Nikolas-05/Magic-Wand/Sketches/01_side_and_top.png

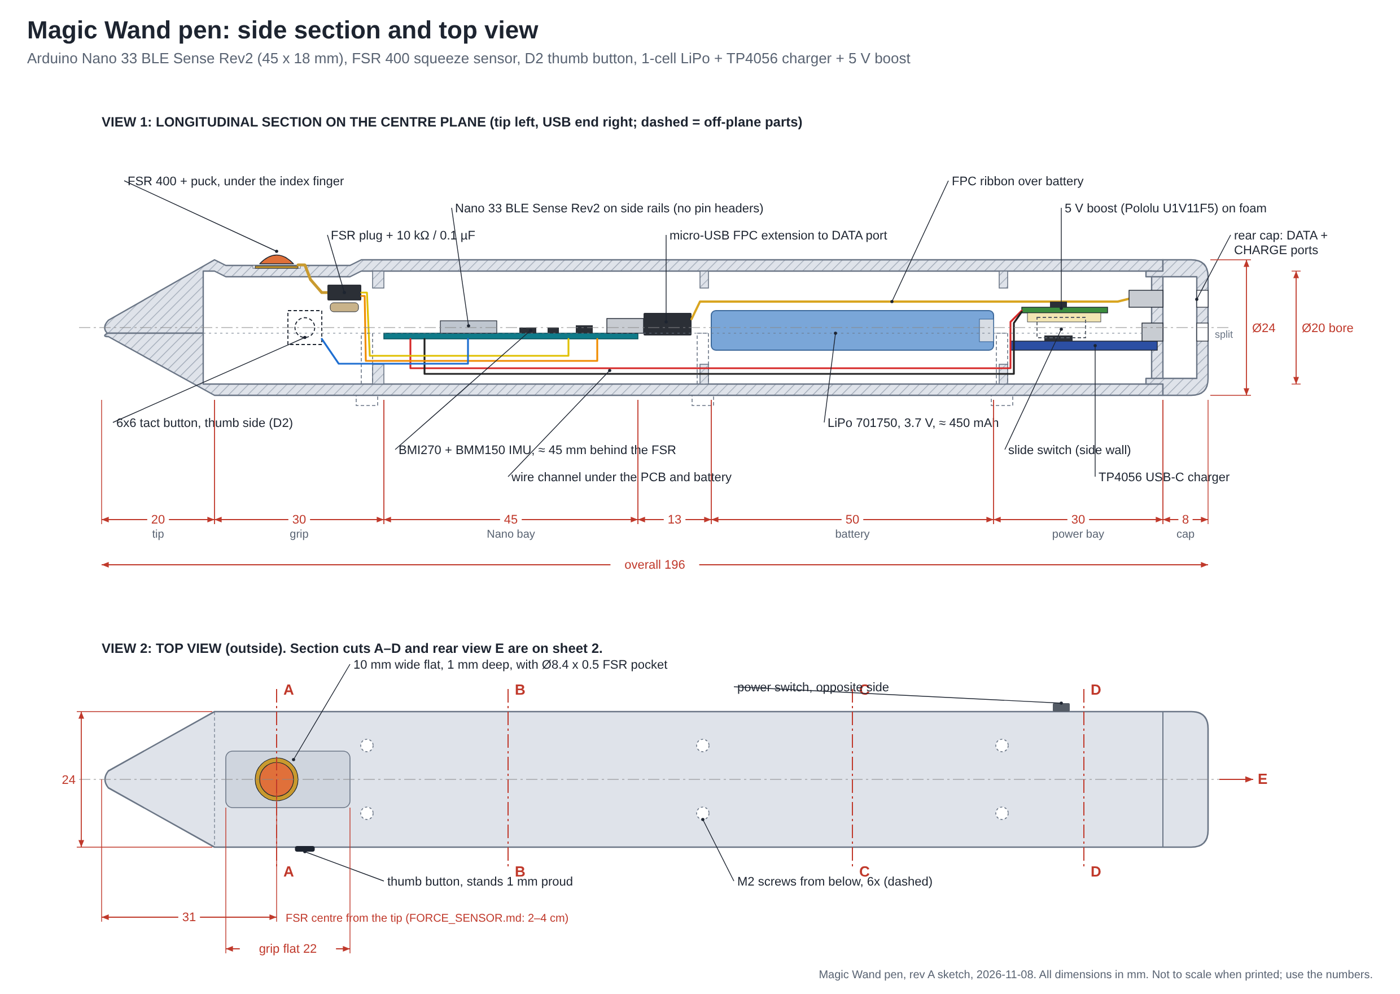
Sketches/01_side_and_top.png
