Nikolas-05/Magic-Wand/Sketches/02_cross_sections.png

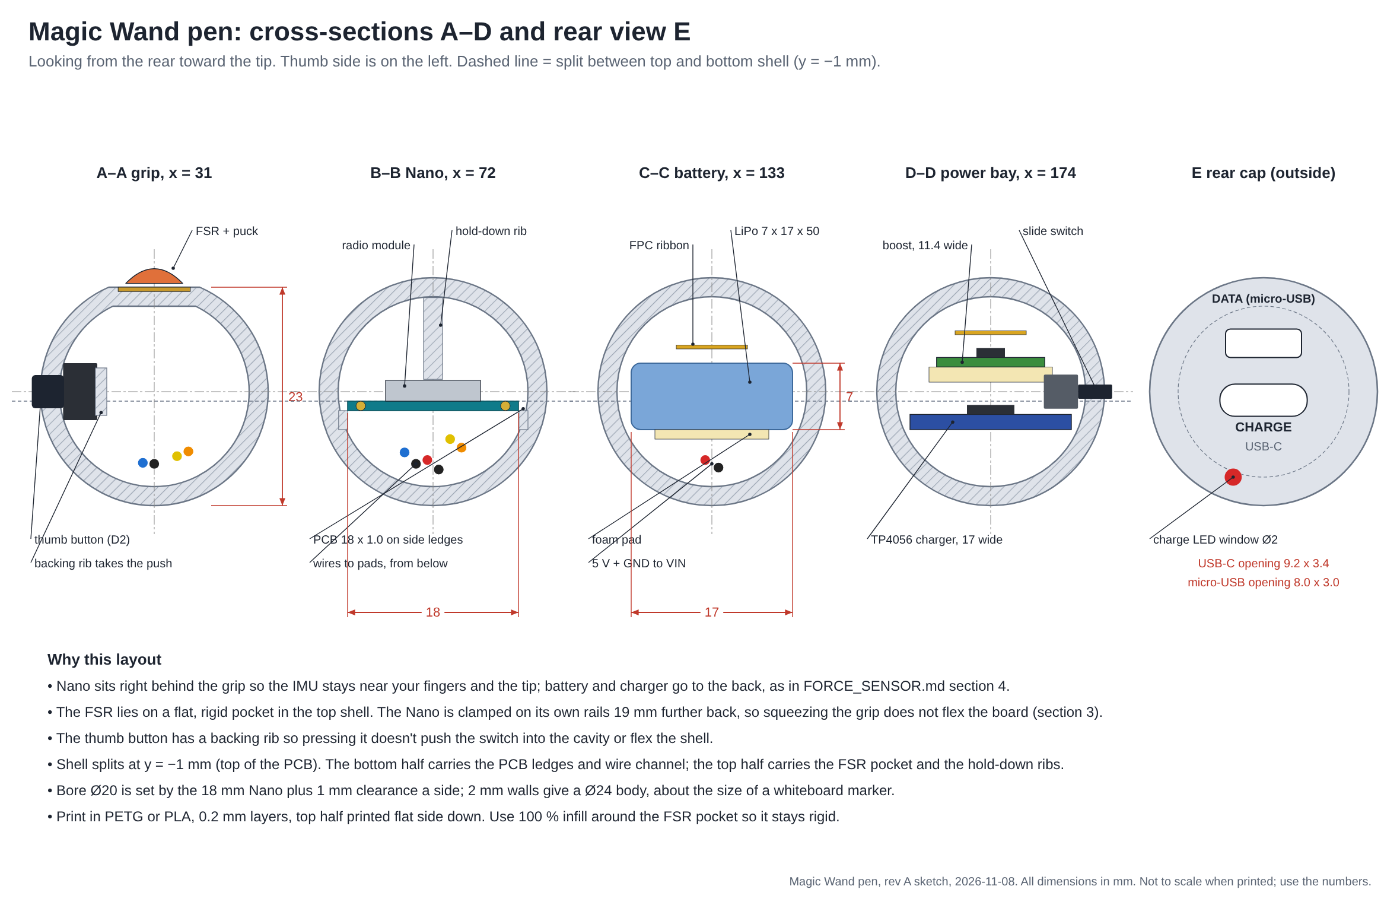
Sketches/02_cross_sections.png
