Nikolas-05/Magic-Wand/Sketches/03_exploded_and_parts.png

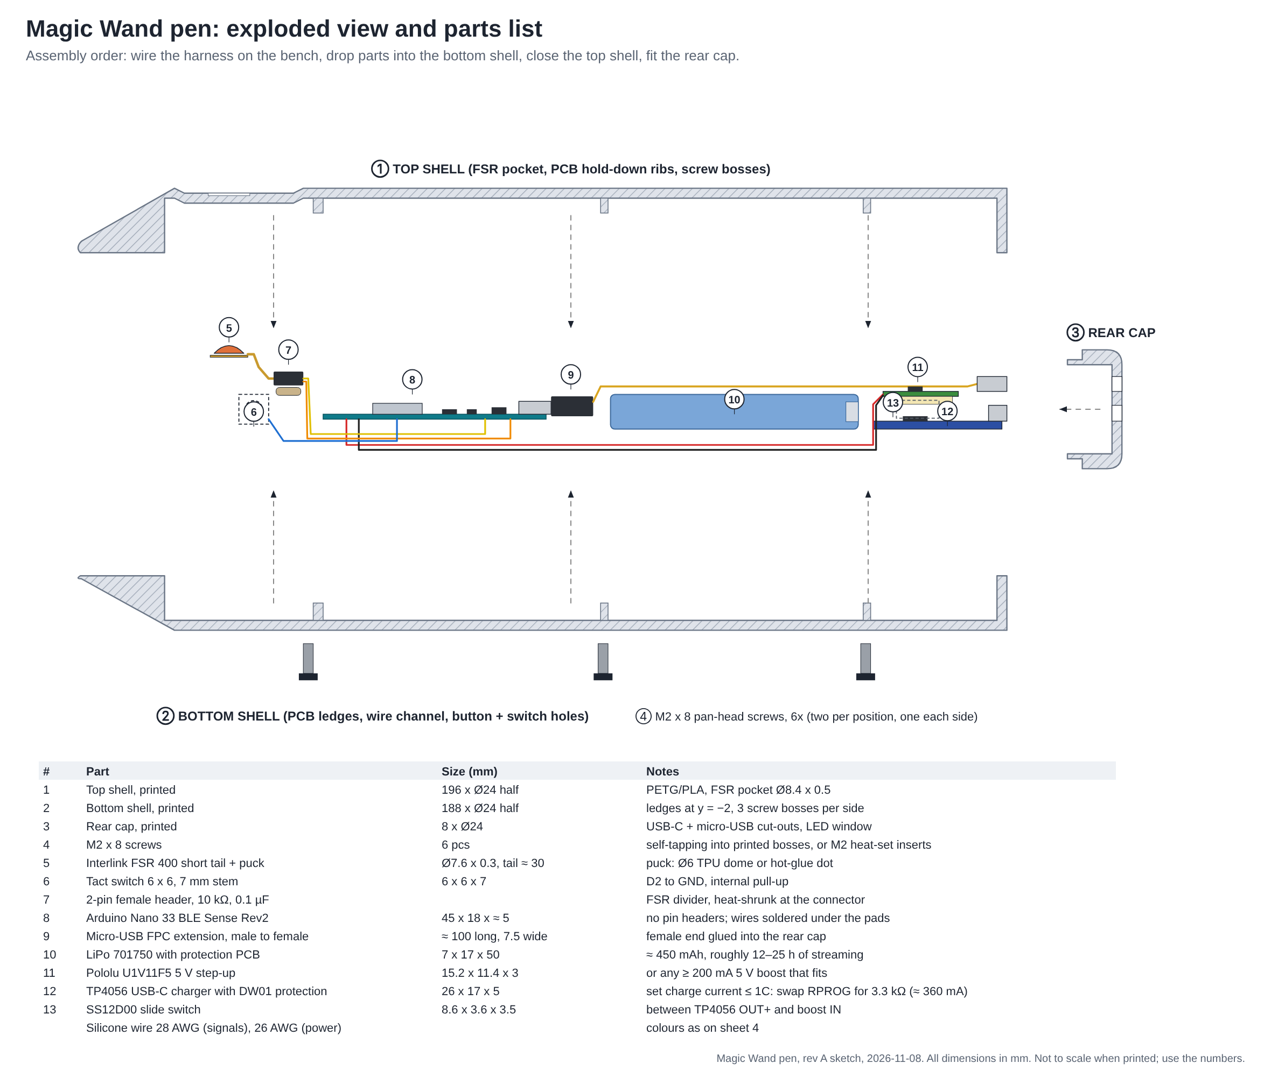
Sketches/03_exploded_and_parts.png
