Nikolas-05/Magic-Wand/Sketches/04_wiring.png

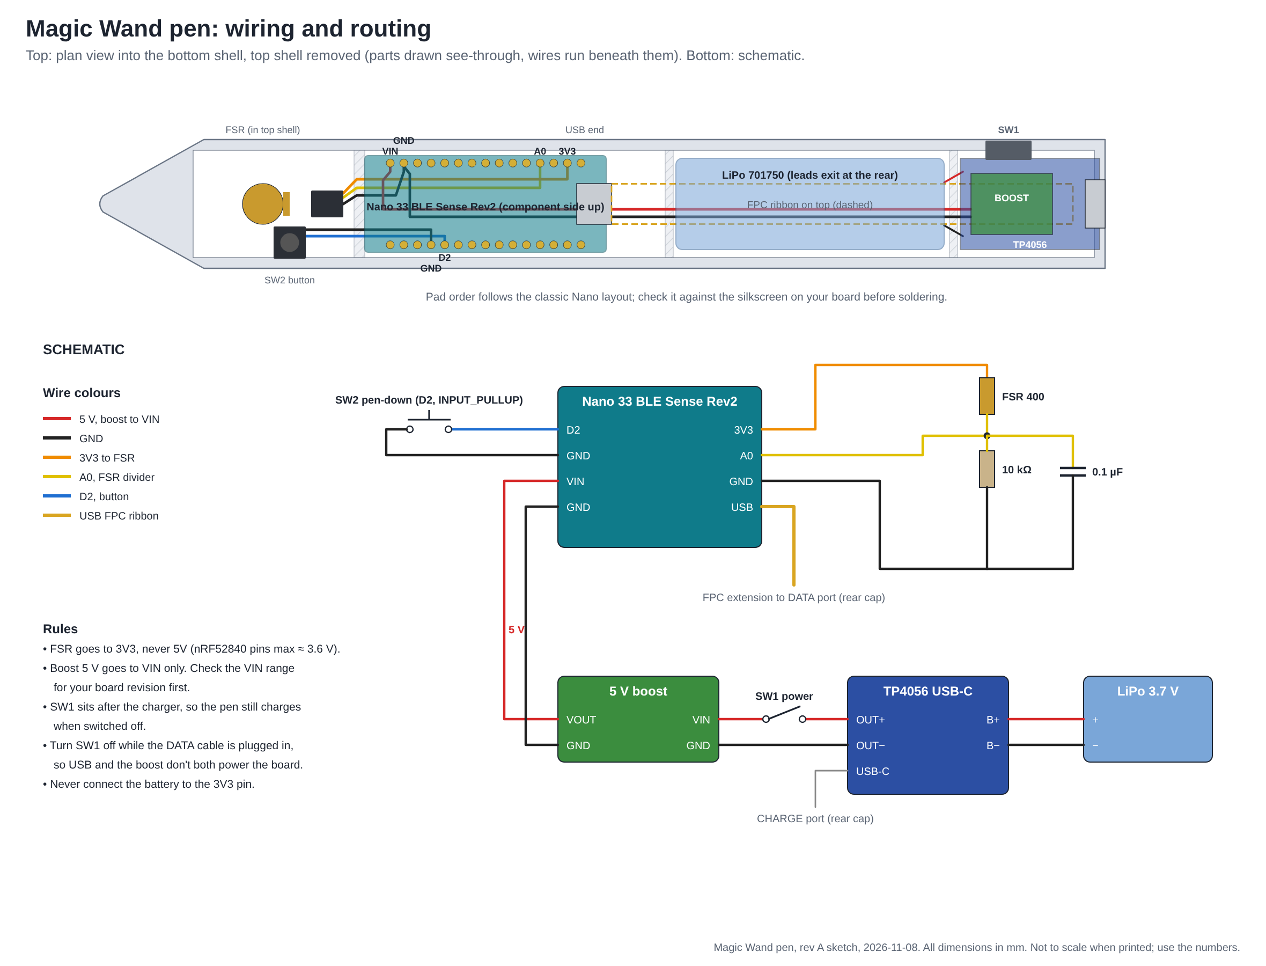
Sketches/04_wiring.png
